abenstirling/SASG/README.md

# SASG
USB-powered, single-channel, low-frequency <b>S</b>ignal <b>A</b>nalyser and <b>S</b>ignal <b>G</b>enerator. 

SASG

## Features
* STM32F103CBT6
* USB-C Power/Communication
* Single-channel
* Low-frequency
* Signal Analyser
* Signal Generator
* 20Hz - 20kHz
